Flynsky/Drone/README.md

# Assembled Drone

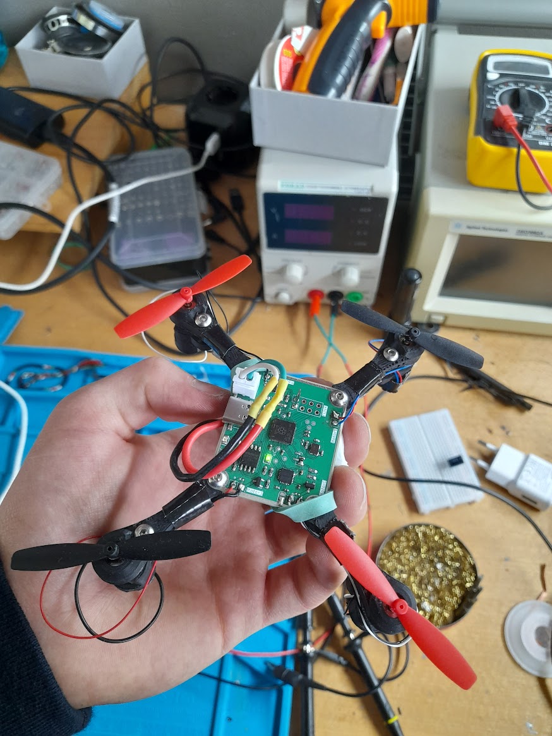
[picture p1: Photos/20240518_153748.jpg]
