Flynsky/Drone/Hardware/V2/Screenshot 2024-05-04 130237.png

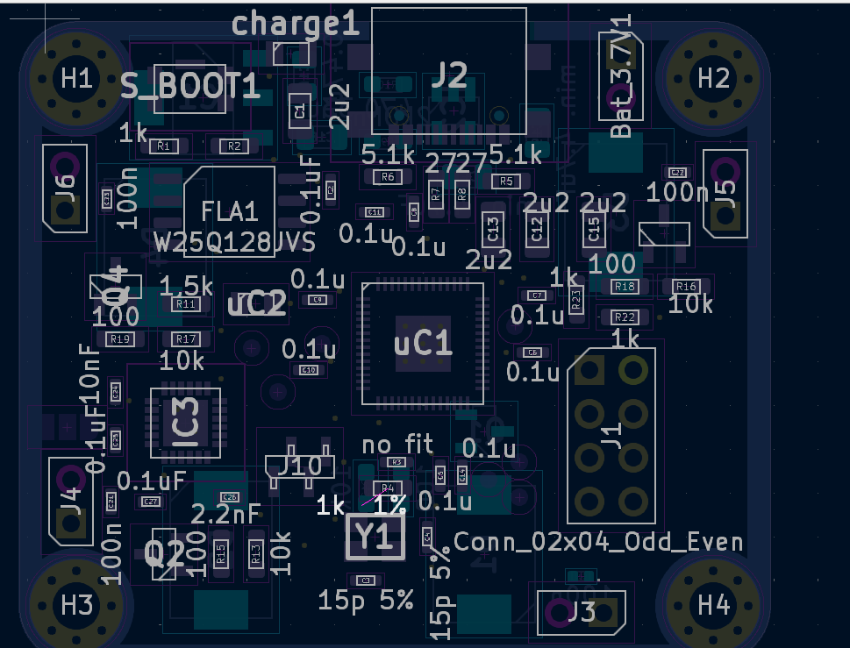
Hardware/V2/Screenshot 2024-05-04 130237.png
