Flynsky/Drone/Hardware/V2/DroneV2.kicad_pcb

## KiCad design Hardware/V2/DroneV2.kicad_pcb (2024-10-19)

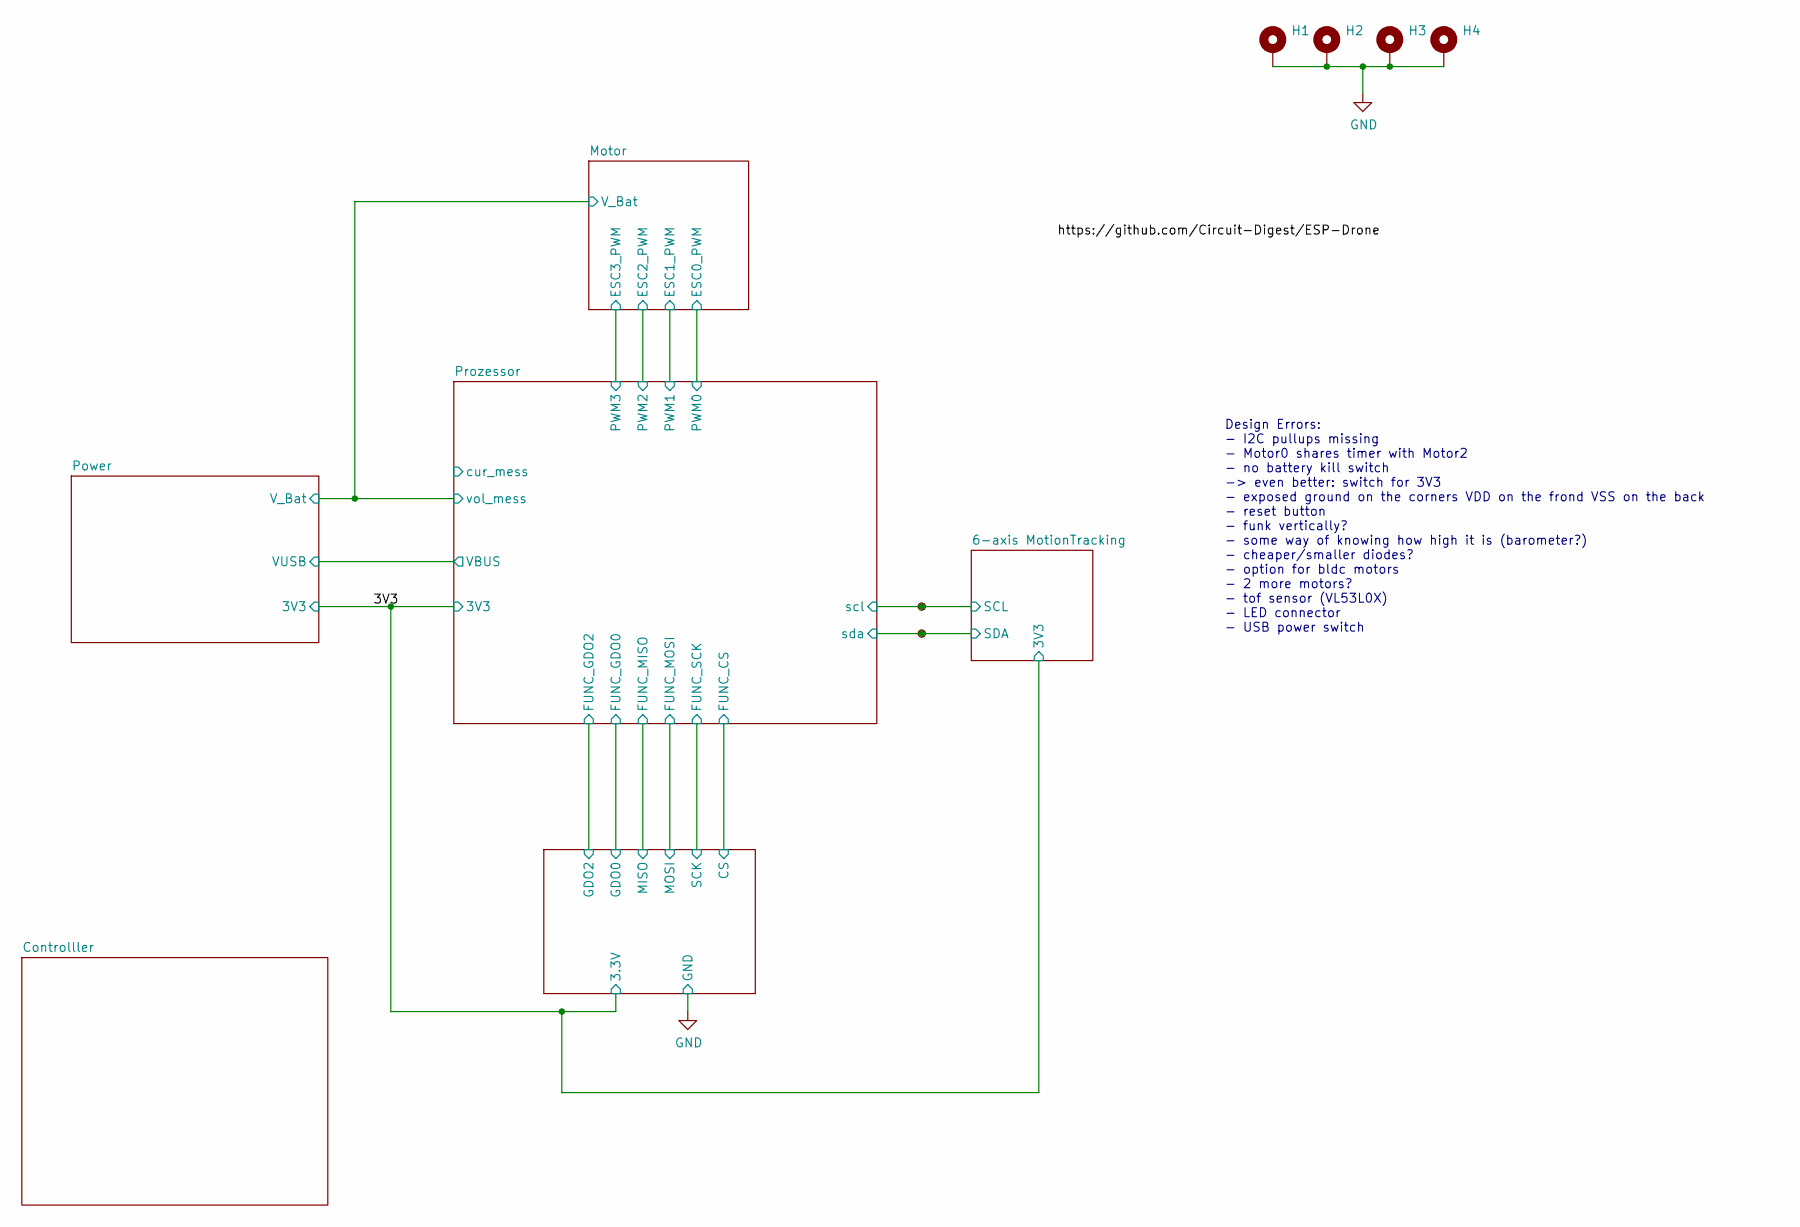
[picture p3: schematic DroneV2.kicad_sch]

Parts:
H1, H2, H3, H4: MountingHole_Pad; MountingHole_2.7mm_Pad_Via
TP1, TP2: TestPoint_Small; TestPoint_Pad_D1.0mm

Connections:
/6-axis MotionTracking/SCL: TP1.1; also elsewhere on the board
/6-axis MotionTracking/SDA: TP2.1; also elsewhere on the board
GND: H1.1, H2.1, H3.1, H4.1; also elsewhere on the board

Notes on the sheet:
Design Errors: - I2C pullups missing - Motor0 shares timer with Motor2 - no battery kill switch -> even better: switch for 3V3 - exposed ground on the corners VDD on the frond VSS on the back - reset button - funk vertically? - some way of knowing how high it is (barometer?) - cheaper/smaller diode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

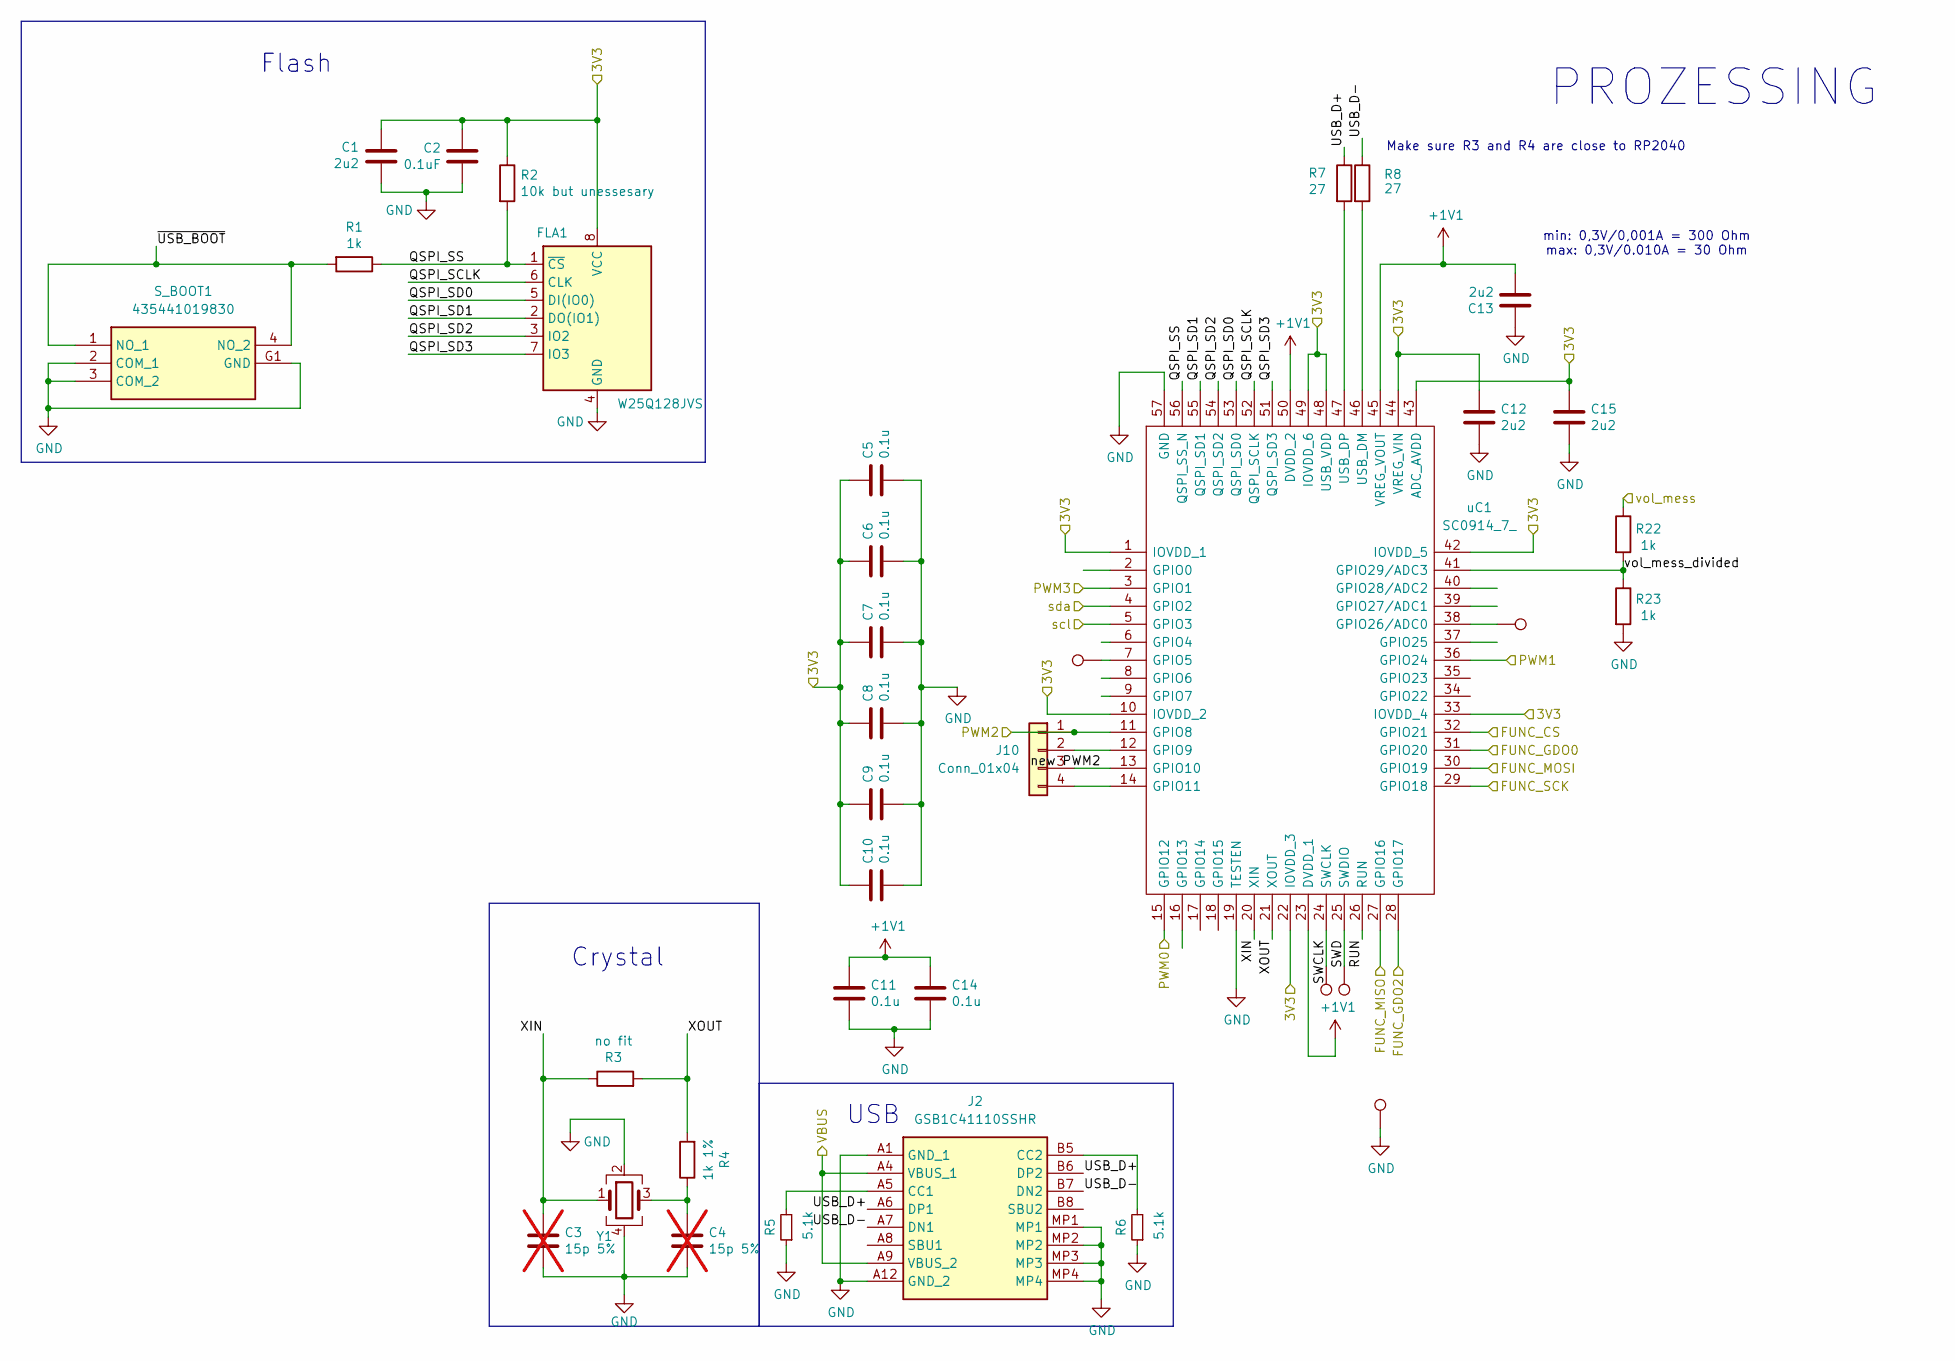
[picture p4: schematic Prozessor.kicad_sch]

Parts:
C1, C12, C13, C15: 2u2; C_0805_2012Metric_Pad1.18x1.45mm_HandSolder
C2: 0.1uF; C_0402_1005Metric_Pad0.74x0.62mm_HandSolder
C3, C4: 15p 5%; C_0402_1005Metric_Pad0.74x0.62mm_HandSolder; not fitted
C5, C6, C7, C8, C9, C10, C11, C14: 0.1u; C_0402_1005Metric_Pad0.74x0.62mm_HandSolder
FLA1: W25Q128JVS; SOIC127P790X216-8N
J2: GSB1C41110SSHR; Manufacturer_Part_Number GSB1C41110SSHR
J10: Conn_01x04; PinHeader_1x04_P1.00mm_Vertical_SMD_Pin1Left
R1, R22, R23: 1k; R_0603_1608Metric_Pad0.98x0.95mm_HandSolder
R2: 10k but unessesary; R_0603_1608Metric_Pad0.98x0.95mm_HandSolder
R3: no fit; R_0402_1005Metric_Pad0.72x0.64mm_HandSolder
R4: 1k 1%; R_0603_1608Metric_Pad0.98x0.95mm_HandSolder
R5, R6: 5.1k; R_0603_1608Metric_Pad0.98x0.95mm_HandSolder
R7, R8: 27; R_0603_1608Metric_Pad0.98x0.95mm_HandSolder
S_BOOT1: 435441019830; Mouser Part Number 710-435441019830
TP3, TP4, TP5, TP6, TP7: TestPoint; TestPoint_Pad_D1.0mm
Y1: ABM8G-12.000MHZ-4Y-T3; ABM8G; Mouser Part Number 815-ABM8G-12-4YT3
uC1: SC0914_7_; QFN40P700X700X90-57N-D; Mouser Part Number 358-SC09147

Connections:
+1V1: C11.1, C13.2, C14.1, uC1.23 (DVDD_1), uC1.45 (VREG_VOUT), uC1.50 (DVDD_2)
/3V3: C1.2, C2.1, C5.1, C6.1, C7.1, C8.1, C9.1, C10.1, C12.1, C15.1, FLA1.8 (VCC), R2.1, uC1.1 (IOVDD_1), uC1.10 (IOVDD_2), uC1.22 (IOVDD_3), uC1.33 (IOVDD_4), uC1.42 (IOVDD_5), uC1.43 (ADC_AVDD), uC1.44 (VREG_VIN), uC1.48 (USB_VDD), uC1.49 (IOVDD_6); also elsewhere on the board
/6-axis MotionTracking/SCL: uC1.5 (GPIO3); also elsewhere on the board
/6-axis MotionTracking/SDA: uC1.4 (GPIO2); also elsewhere on the board
/Funk/CS: uC1.32 (GPIO21); also elsewhere on the board
/Funk/GDO0: uC1.31 (GPIO20); also elsewhere on the board
/Funk/GDO2: uC1.28 (GPIO17); also elsewhere on the board
/Funk/MISO: uC1.27 (GPIO16); also elsewhere on the board
/Funk/MOSI: uC1.30 (GPIO19); also elsewhere on the board
/Funk/SCK: uC1.29 (GPIO18); also elsewhere on the board
/Motor/ESC0_PWM: uC1.15 (GPIO12); also elsewhere on the board
/Motor/ESC1_PWM: uC1.36 (GPIO24); also elsewhere on the board
/Motor/ESC2_PWM: J10.1, uC1.11 (GPIO8); also elsewhere on the board
/Motor/ESC3_PWM: uC1.3 (GPIO1); also elsewhere on the board
/Motor/V_Bat: R22.1; also elsewhere on the board
/Power/VUSB: J2.A4 (VBUS_1), J2.A9 (VBUS_2); also elsewhere on the board
/Prozessor/QSPI_SCLK: FLA1.6 (CLK), uC1.52 (QSPI_SCLK)
/Prozessor/QSPI_SD0: FLA1.5 (DI(IO0)), uC1.53 (QSPI_SD0)
/Prozessor/QSPI_SD1: FLA1.2 (DO(IO1)), uC1.55 (QSPI_SD1)
/Prozessor/QSPI_SD2: FLA1.3 (IO2), uC1.54 (QSPI_SD2)
/Prozessor/QSPI_SD3: FLA1.7 (IO3), uC1.51 (QSPI_SD3)
/Prozessor/QSPI_SS: FLA1.1 (~CS), R1.1, R2.2, uC1.56 (QSPI_SS_N)
/Prozessor/RUN: uC1.26 (RUN)
/Prozessor/SWCLK: TP3.1, uC1.24 (SWCLK)
/Prozessor/SWD: TP4.1, uC1.25 (SWDIO)
/Prozessor/USB_D+: J2.A6 (DP1), J2.B6 (DP2), R7.1
/Prozessor/USB_D-: J2.A7 (DN1), J2.B7 (DN2), R8.1
/Prozessor/XIN: C3.1, R3.1, Y1.1, uC1.20 (XIN)
/Prozessor/XOUT: R3.2, R4.2, uC1.21 (XOUT)
/Prozessor/new PWM2: J10.3, uC1.13 (GPIO10)
/Prozessor/vol_mess_divided: R22.2, R23.1, uC1.41 (GPIO29/ADC3)
/Prozessor/~USB_BOOT: R1.2, S_BOOT1.1 (NO_1), S_BOOT1.4 (NO_2)
GND: C1.1, C2.2, C3.2, C4.2, C5.2, C6.2, C7.2, C8.2, C9.2, C10.2, C11.2, C12.2, C13.1, C14.2, C15.2, FLA1.4 (GND), J2.A1 (GND_1), J2.A12 (GND_2), J2.MP1, J2.MP2, J2.MP3, J2.MP4, R5.1, R6.1, R23.2, S_BOOT1.2 (COM_1), S_BOOT1.3 (COM_2), S_BOOT1.G1 (GND), TP5.1, Y1.2, Y1.4, uC1.19 (TESTEN), uC1.57 (GND); also elsewhere on the board
unnamed: C4.1, R4.1, Y1.3
unnamed: J2.A5 (CC1), R5.2
unnamed: J2.B5 (CC2), R6.2
unnamed: J10.2, uC1.12 (GPIO9)
unnamed: J10.4, uC1.14 (GPIO11)
unnamed: TP7.1, uC1.7 (GPIO5)
unnamed: TP6.1, uC1.38 (GPIO26/ADC0)
unnamed: R8.2, uC1.46 (USB_DM)
unnamed: R7.2, uC1.47 (USB_DP)

Notes on the sheet:
Flash
min: 0,3V/0,001A = 300 Ohm max: 0,3V/0.010A = 30 Ohm
Crystal
PROZESSING
Make sure R3 and R4 are close to RP2040
USB

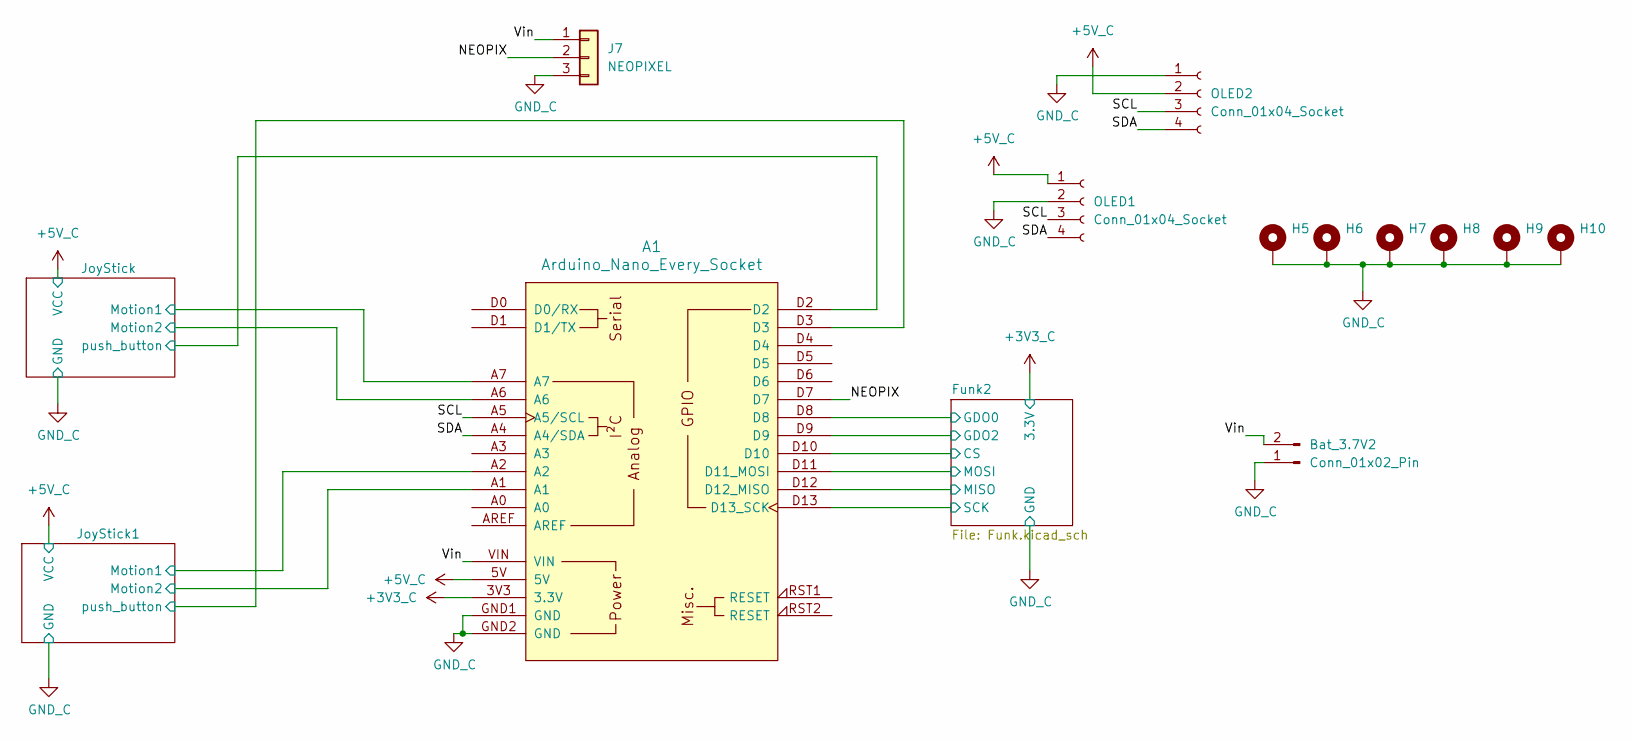
[picture p5: schematic Controlller.kicad_sch]

Parts:
A1: Arduino_Nano_Every_Socket
Bat_3.7V2: Conn_01x02_Pin; PinSocket_1x02_P2.54mm_Vertical
H5, H6, H7, H8, H9, H10: MountingHole_Pad; MountingHole_2.2mm_M2_DIN965_Pad
J7: NEOPIXEL; PinHeader_1x03_P2.54mm_Vertical
OLED1, OLED2: Conn_01x04_Socket; PinHeader_1x04_P2.54mm_Vertical

Connections:
+5V_C: A1.5V, OLED1.1, OLED2.2; also elsewhere on the board
/Controlller/NEOPIX: A1.D7, J7.2
/Controlller/SCL: A1.A5 (A5/SCL), OLED1.3, OLED2.3
/Controlller/SDA: A1.A4 (A4/SDA), OLED1.4, OLED2.4
/Controlller/Vin: A1.VIN, Bat_3.7V2.2, J7.1
GND_C: A1.GND1 (GND), A1.GND2 (GND), Bat_3.7V2.1, H5.1, H6.1, H7.1, H8.1, H9.1, H10.1, J7.3, OLED1.2, OLED2.1; also elsewhere on the board

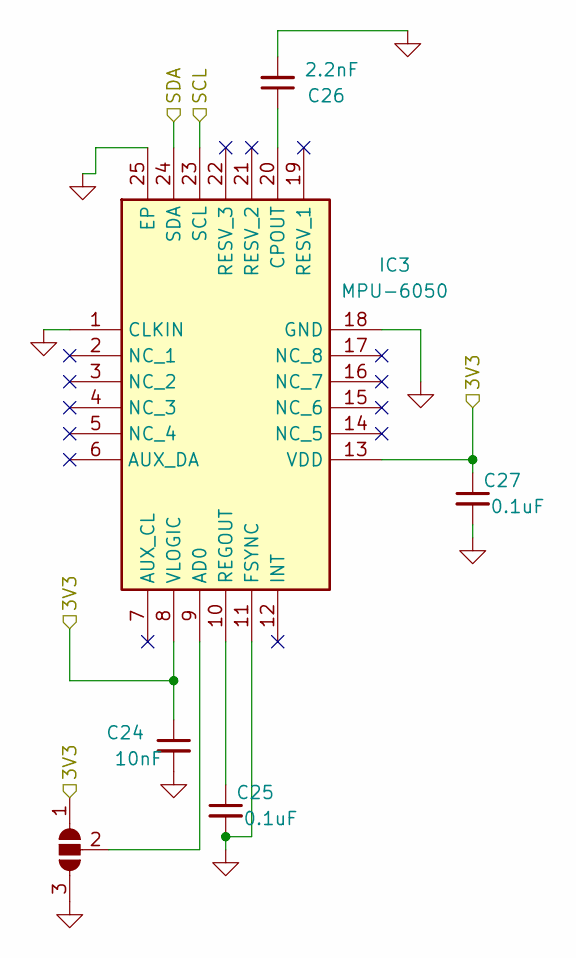
[picture p6: schematic 6-axis MotionTracking.kicad_sch]

Parts:
C24: 10nF; C_0402_1005Metric
C25, C27: 0.1uF; C_0402_1005Metric
C26: 2.2nF; C_0402_1005Metric
IC3: MPU-6050; MPU6050; Mouser Part Number 410-MPU-6050
JP1: SolderJumper_3_Open; SolderJumper-3_P1.3mm_Open_RoundedPad1.0x1.5mm_NumberLabels

Connections:
/3V3: C24.1, C27.1, IC3.8 (VLOGIC), IC3.13 (VDD), JP1.1 (A); also elsewhere on the board
/6-axis MotionTracking/SCL: IC3.23 (SCL); also elsewhere on the board
/6-axis MotionTracking/SDA: IC3.24 (SDA); also elsewhere on the board
GND: C24.2, C25.2, C26.2, C27.2, IC3.1 (CLKIN), IC3.11 (FSYNC), IC3.18 (GND), IC3.25 (EP), JP1.3 (B); also elsewhere on the board
unnamed: IC3.9 (AD0), JP1.2 (C)
unnamed: C26.1, IC3.20 (CPOUT)
unnamed: C25.1, IC3.10 (REGOUT)

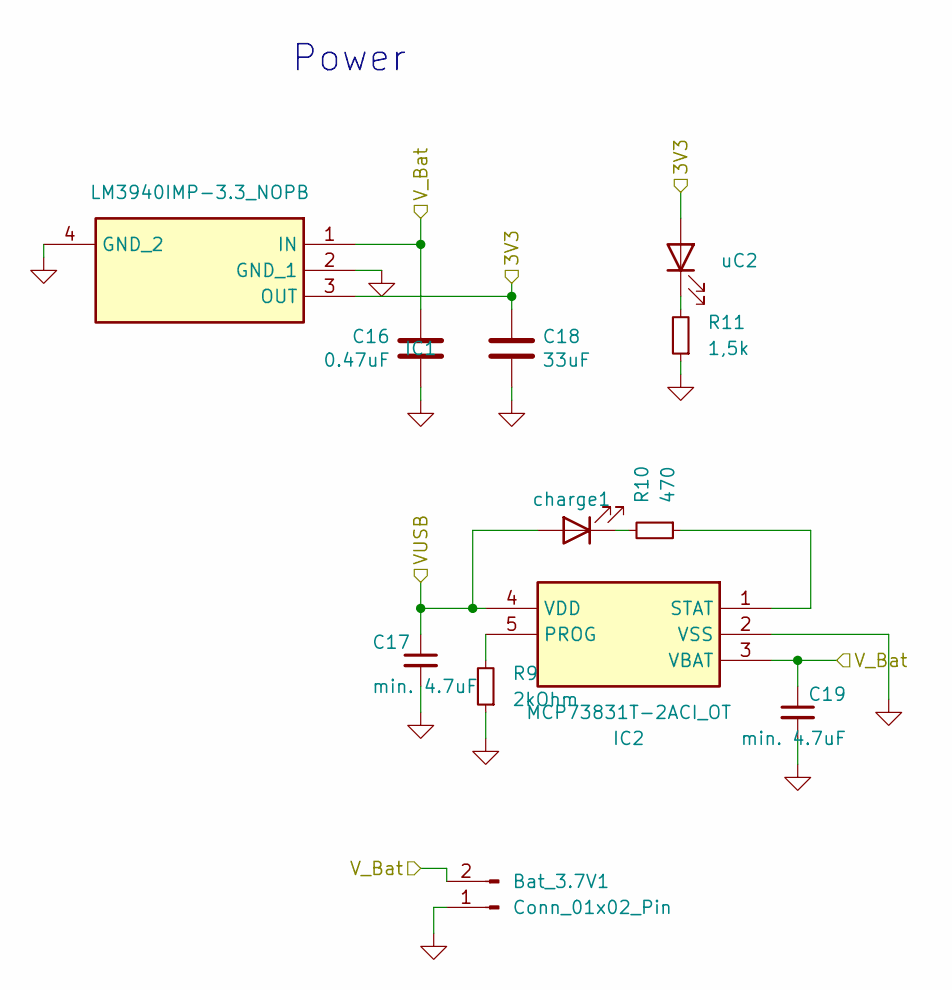
[picture p7: schematic Power.kicad_sch]

Parts:
Bat_3.7V1: Conn_01x02_Pin; PinSocket_1x02_P2.54mm_Vertical
C16: 0.47uF; C_0805_2012Metric
C17, C19: min. 4.7uF; C_0805_2012Metric
C18: 33uF; C_0805_2012Metric
IC1: LM3940IMP-3.3_NOPB; SOT230P700X180-4N; Mouser Part Number 926-LM3940IMP3.3NOPB
IC2: MCP73831T-2ACI_OT; SOT95P270X145-5N; Mouser Part Number 579-MCP73831T-2ACIOT
R9: 2kOhm; R_0603_1608Metric_Pad0.98x0.95mm_HandSolder
R10: 470; R_0603_1608Metric_Pad0.98x0.95mm_HandSolder
R11: 1,5k; R_0603_1608Metric_Pad0.98x0.95mm_HandSolder
charge1: APTD2012LCGCK; LEDC2012X120N; Mouser Part Number 604-APTD2012LCGCK
uC2: APTD2012LCGCK; LEDC2012X120N; Mouser Part Number 604-APTD2012LCGCK

Connections:
/3V3: C18.1, IC1.3 (OUT), uC2.2 (A); also elsewhere on the board
/Motor/V_Bat: Bat_3.7V1.2, C16.1, C19.1, IC1.1 (IN), IC2.3 (VBAT); also elsewhere on the board
/Power/VUSB: C17.1, IC2.4 (VDD), charge1.2 (A); also elsewhere on the board
GND: Bat_3.7V1.1, C16.2, C17.2, C18.2, C19.2, IC1.2 (GND_1), IC1.4 (GND_2), IC2.2 (VSS), R9.1, R11.1; also elsewhere on the board
unnamed: IC2.5 (PROG), R9.2
unnamed: IC2.1 (STAT), R10.1
unnamed: R10.2, charge1.1 (K)
unnamed: R11.2, uC2.1 (K)

Notes on the sheet:
Power

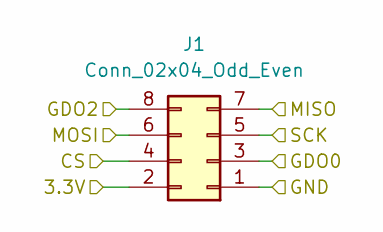
[picture p8: schematic Funk.kicad_sch]

Parts:
J1: Conn_02x04_Odd_Even; PinHeader_2x04_P2.54mm_Vertical

Connections:
/3V3: J1.2; also elsewhere on the board
/Funk/CS: J1.4; also elsewhere on the board
/Funk/GDO0: J1.3; also elsewhere on the board
/Funk/GDO2: J1.8; also elsewhere on the board
/Funk/MISO: J1.7; also elsewhere on the board
/Funk/MOSI: J1.6; also elsewhere on the board
/Funk/SCK: J1.5; also elsewhere on the board
GND: J1.1; also elsewhere on the board

Parts of its further copies:
J8: Conn_02x04_Odd_Even; PinHeader_2x04_P2.54mm_Vertical

Connections of its further copies:
+3V3_C: J8.2
/Controlller/Funk2/CS: J8.4
/Controlller/Funk2/GDO0: J8.3
/Controlller/Funk2/GDO2: J8.8
/Controlller/Funk2/MISO: J8.7
/Controlller/Funk2/MOSI: J8.6
/Controlller/Funk2/SCK: J8.5
GND_C: J8.1; also elsewhere on the board

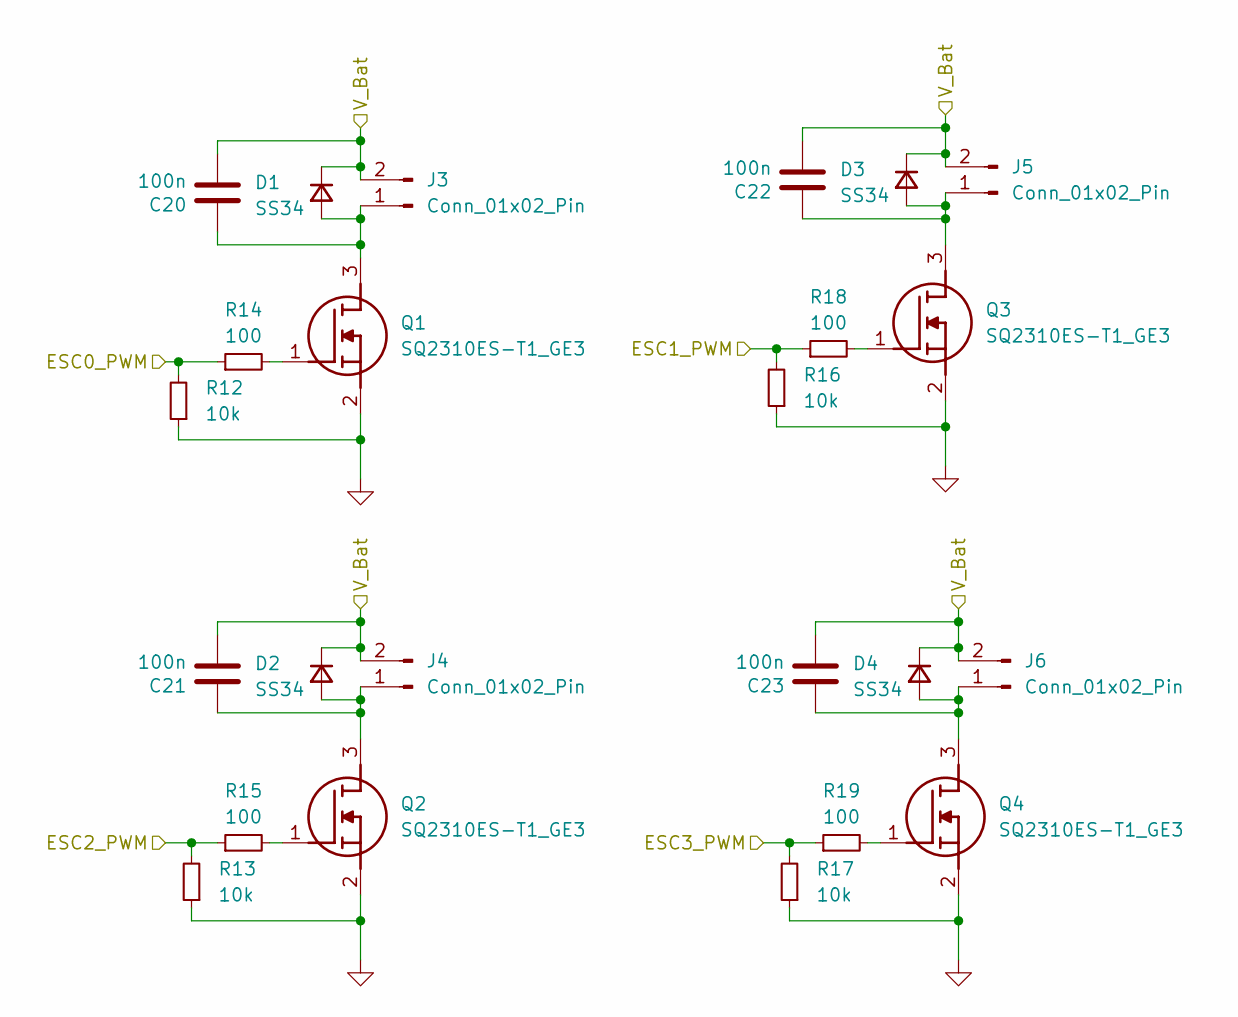
[picture p9: schematic Motors.kicad_sch]

Parts:
C20, C21, C22, C23: 100n; C_0402_1005Metric
D1, D2, D3, D4: SS34; DIOM8059X256N; Mouser Part Number 821-SS34
J3, J4, J5, J6: Conn_01x02_Pin; PinSocket_1x02_P2.54mm_Vertical
Q1, Q2, Q3, Q4: SQ2310ES-T1_GE3; SOT95P237X112-3N; Mouser Part Number 78-SQ2310ES-T1_GE3
R12, R13, R16, R17: 10k; R_0603_1608Metric_Pad0.98x0.95mm_HandSolder
R14, R15, R18, R19: 100; R_0603_1608Metric_Pad0.98x0.95mm_HandSolder

Connections:
/Motor/ESC0_PWM: R12.2, R14.1; also elsewhere on the board
/Motor/ESC1_PWM: R16.2, R18.1; also elsewhere on the board
/Motor/ESC2_PWM: R13.2, R15.1; also elsewhere on the board
/Motor/ESC3_PWM: R17.2, R19.1; also elsewhere on the board
/Motor/V_Bat: C20.2, C21.2, C22.2, C23.2, D1.1 (K), D2.1 (K), D3.1 (K), D4.1 (K), J3.2, J4.2, J5.2, J6.2; also elsewhere on the board
GND: Q1.2 (S), Q2.2 (S), Q3.2 (S), Q4.2 (S), R12.1, R13.1, R16.1, R17.1; also elsewhere on the board
unnamed: C20.1, D1.2 (A), J3.1, Q1.3 (D)
unnamed: C21.1, D2.2 (A), J4.1, Q2.3 (D)
unnamed: C22.1, D3.2 (A), J5.1, Q3.3 (D)
unnamed: C23.1, D4.2 (A), J6.1, Q4.3 (D)
unnamed: Q1.1 (G), R14.2
unnamed: Q2.1 (G), R15.2
unnamed: Q3.1 (G), R18.2
unnamed: Q4.1 (G), R19.2

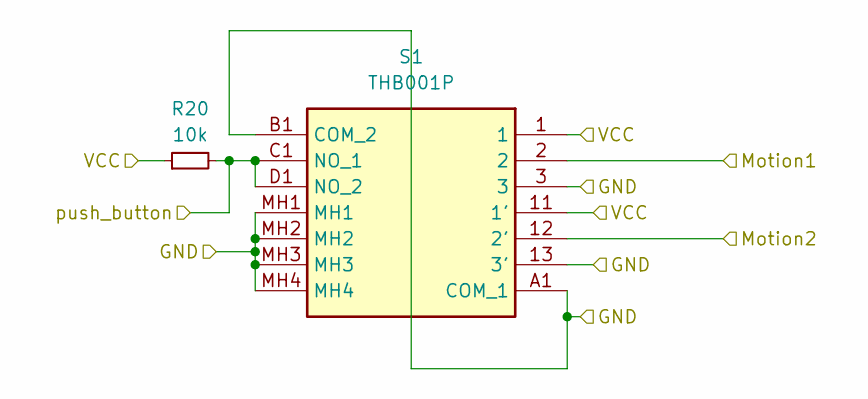
[picture p10: schematic JoyStick.kicad_sch]

Parts:
R20: 10k; R_0603_1608Metric_Pad0.98x0.95mm_HandSolder
S1: THB001P; Mouser Part Number 611-THB001P

Connections:
+5V_C: R20.1, S1.1, S1.11 (1'); also elsewhere on the board
/Controlller/JoyStick/Motion1: S1.2
/Controlller/JoyStick/Motion2: S1.12 (2')
/Controlller/JoyStick/push_button: R20.2, S1.C1 (NO_1), S1.D1 (NO_2)
GND_C: S1.3, S1.13 (3'), S1.A1 (COM_1), S1.B1 (COM_2), S1.MH1, S1.MH2, S1.MH3, S1.MH4; also elsewhere on the board

Parts of its further copies:
R21: 10k; R_0603_1608Metric_Pad0.98x0.95mm_HandSolder
S2: THB001P; Mouser Part Number 611-THB001P

Connections of its further copies:
+5V_C: R21.1, S2.1, S2.11 (1'); also elsewhere on the board
/Controlller/JoyStick1/Motion1: S2.2
/Controlller/JoyStick1/Motion2: S2.12 (2')
/Controlller/JoyStick1/push_button: R21.2, S2.C1 (NO_1), S2.D1 (NO_2)
GND_C: S2.3, S2.13 (3'), S2.A1 (COM_1), S2.B1 (COM_2), S2.MH1, S2.MH2, S2.MH3, S2.MH4; also elsewhere on the board

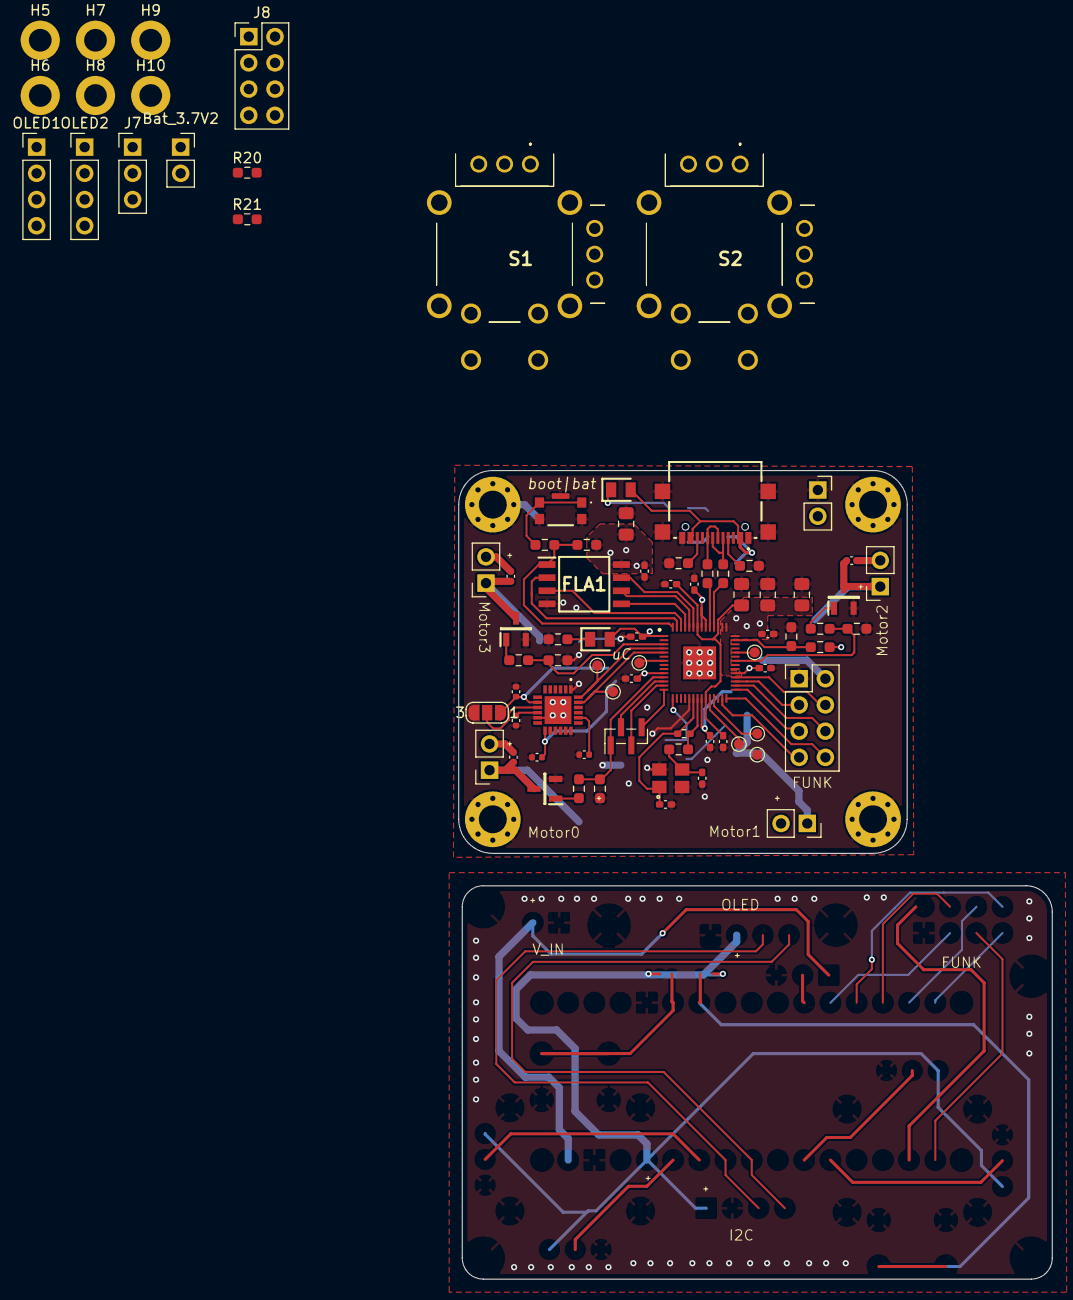
[picture p11: board DroneV2.kicad_pcb from above]

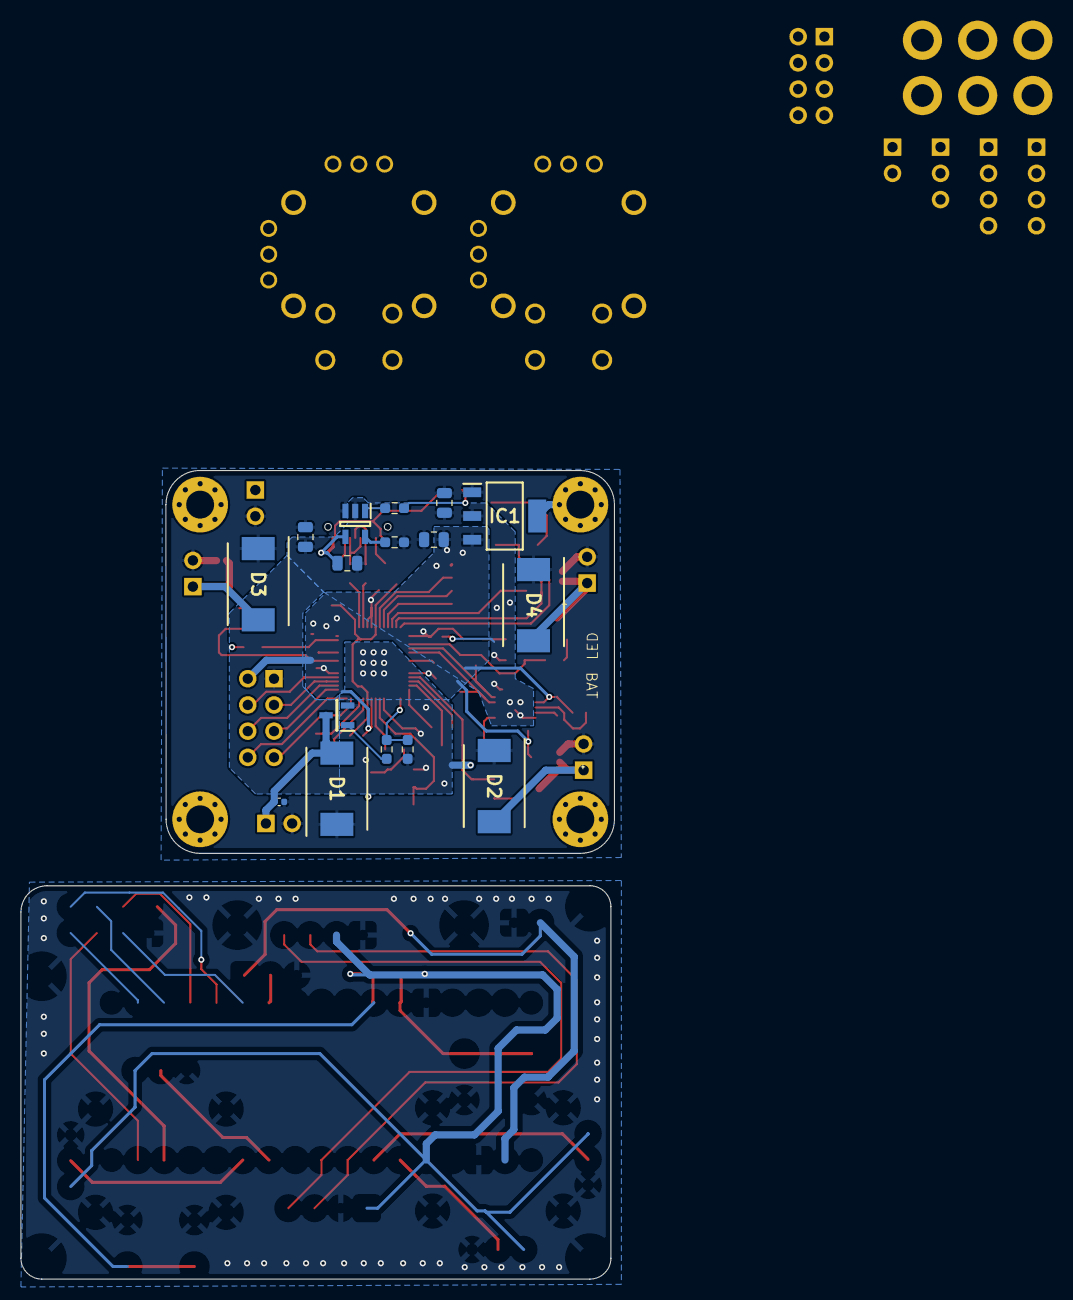
[picture p12: board DroneV2.kicad_pcb from below]

Board: 2 copper layers, 43.4 x 37.1 mm, 100 parts (16 on the bottom side), 63 nets.
