Flynsky/Drone/Software/V1/Firmware_Controller/src/Controller.cpp

#include "Arduino.h"
#include <RadioLib.h>

#define RADIO_CS 10
#define RADIO_MISO 12
#define RADIO_MOSI 11
#define RADIO_SCK 13
#define RADIO_GDO0 8
#define RADIO_GDO2 9

CC1101 radio = new Module(RADIO_CS, RADIO_GDO0, RADIOLIB_NC, RADIO_GDO2);
void radio_setup();
void radio_transmit();

// save transmission state between loops
int transmissionState = RADIOLIB_ERR_NONE;
// flag to indicate that a packet was sent
volatile bool transmittedFlag = false;
void setFlag(void)
{
  // we sent a packet, set the flag
  transmittedFlag = true;
}
// counter to keep track of transmitted packets
int count = 0;

char funk_init = 0;
void setup()
{
  Serial.begin(9600);
  while (!Serial)
  {
  }
  delay(100);
  Serial.println("<<Controller>>");
  delay(100);
}

void loop()
{
  radio_transmit();
}

void radio_setup()
{
  // initialize CC1101 with default settings
  Serial.print(F("[CC1101] Initializing ... "));
  int state = radio.begin();
  if (state == RADIOLIB_ERR_NONE)
  {
    radio.setFrequency(433);
    Serial.println(F("success!"));
    funk_init = 1;
  }
  else
  {
    Serial.print(F("failed, code "));
    Serial.println(state);
    while (true)
      ;
  }

  // set the function that will be called
  // when packet transmission is finished
  radio.setPacketSentAction(setFlag);

  // start transmitting the first packet
  Serial.print(F("[CC1101] Sending first packet ... "));

  // you can transmit C-string or Arduino string up to
  // 64 characters long
  transmissionState = radio.startTransmit("Hello World!");

  // you can also transmit byte array up to 64 bytes long
  /*
    byte byteArr[] = {0x01, 0x23, 0x45, 0x56,
                      0x78, 0xAB, 0xCD, 0xEF};
    state = radio.startTransmit(byteArr, 8);
  */
}

unsigned int counter = 0;
void radio_transmit()
{
  if (!funk_init)
  {
    radio_setup();
  }
  // check if the previous transmission finished
  if (transmittedFlag)
  {
    // reset flag
    transmittedFlag = false;

    if (transmissionState == RADIOLIB_ERR_NONE)
    {
      // packet was successfully sent
      Serial.println(F("transmission finished!"));

      // NOTE: when using interrupt-driven transmit method,
      //       it is not possible to automatically measure
      //       transmission data rate using getDataRate()
    }
    else
    {
      Serial.print(F("failed, code "));
      Serial.println(transmissionState);
    }

    // clean up after transmission is finished
    // this will ensure transmitter is disabled,
    // RF switch is powered down etc.
    radio.finishTransmit();

    // wait a second before transmitting again
    delay(1000);

    // send another one
    Serial.print(F("[CC1101] Sending another packet ... "));

    // you can transmit C-string or Arduino string up to
    // 256 characters long
    String str = "Hello World! #" + String(count++);
    transmissionState = radio.startTransmit(str);

    // you can also transmit byte array up to 256 bytes long
    /*
      byte byteArr[] = {0x01, 0x23, 0x45, 0x67,
                        0x89, 0xAB, 0xCD, 0xEF};
      int state = radio.startTransmit(byteArr, 8);
    */
  }
}
