Flynsky/Drone/(commit log)

2024-06-16 pushing current status
    [6-axis MotionTracking.kicad_sch, Controlller.kicad_sch, Drone.kicad_pcb, Drone.kicad_sch, Funk.kicad_sch, JoyStick.kicad_sch, Motors.kicad_sch, Power.kicad_sch]
2024-06-21 updates pid
2024-06-21 boosted pid controller
    [6-axis MotionTracking.kicad_sch, Controlller.kicad_sch, Drone.kicad_sch, Funk.kicad_sch, JoyStick.kicad_sch, Motors.kicad_sch, Power.kicad_sch, Prozessor.kicad_sch]
2024-10-19 added current version
    [6-axis MotionTracking.kicad_sch, Controlller.kicad_sch, Drone.kicad_pcb, Drone.kicad_sch, DroneV2.kicad_pcb, DroneV2.kicad_sch, Funk.kicad_sch, JoyStick.kicad_sch]
